wilson-mura/m4-avionics/README.md

# Martlet IV Avionics

This repository contains all the avionics for Martlet 4, including system 
design, documentation, schematics, PCBs, and firmware.
