wilson-mura/m4-avionics/m4pyro/schematic.pdf

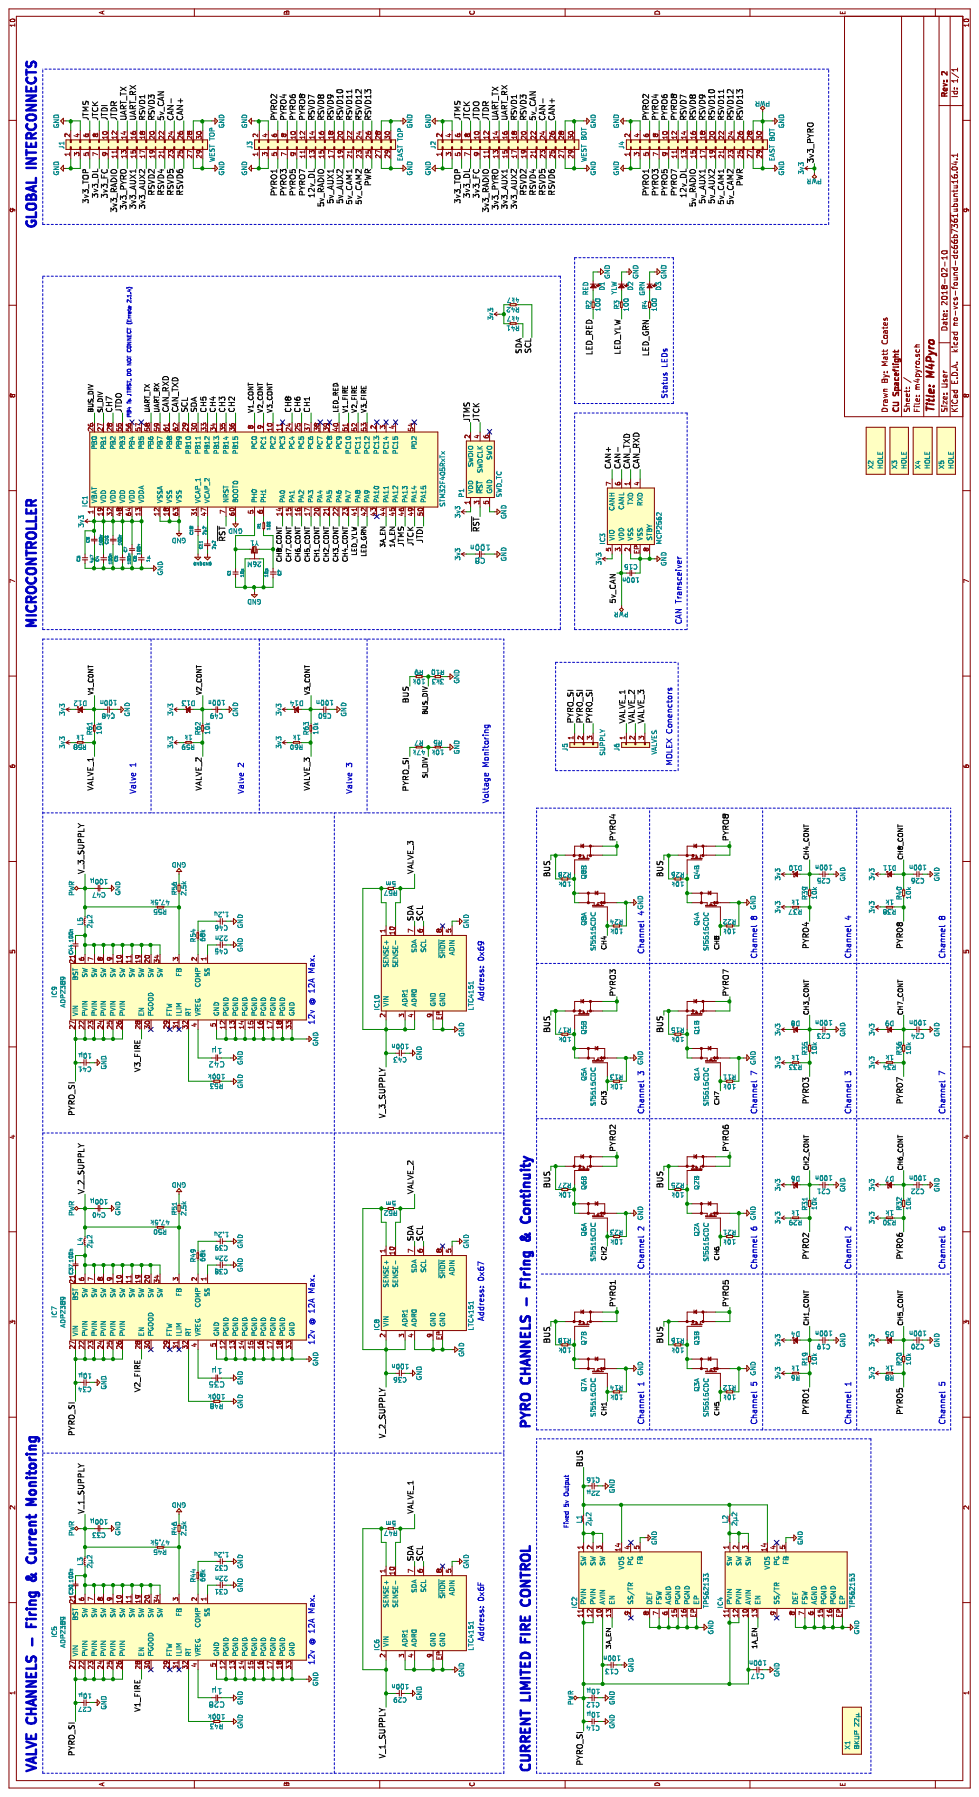
[picture p7: page 1]
