wilson-mura/m4-avionics/m4pyro/m4pyro.pdf

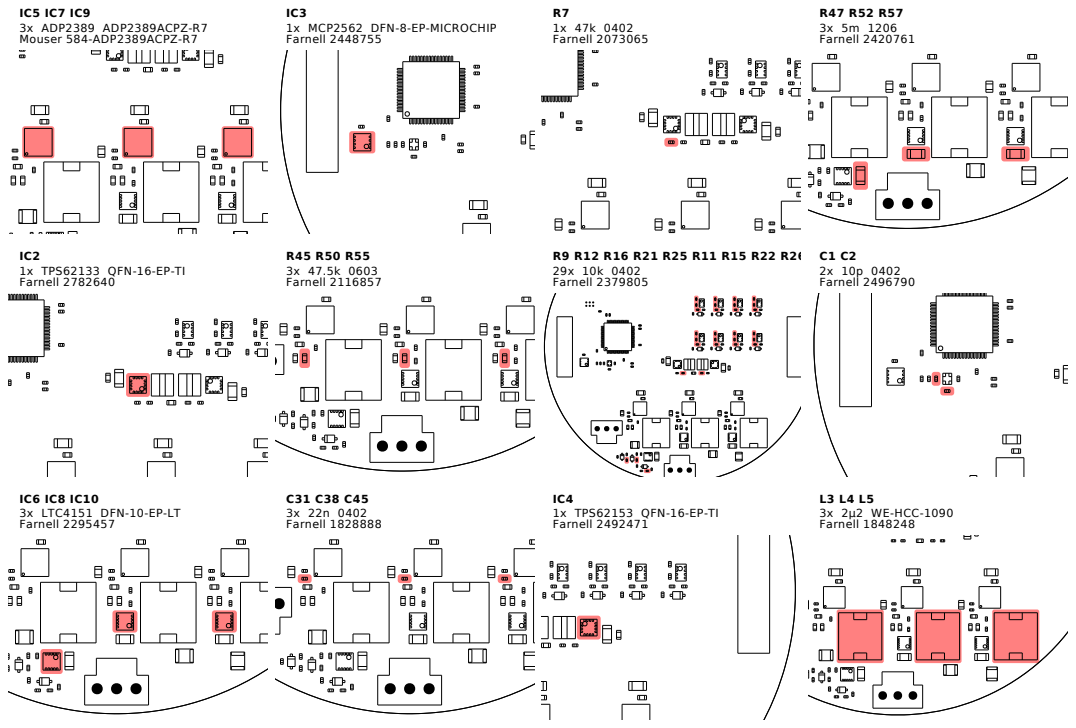
[picture p8: page 1]

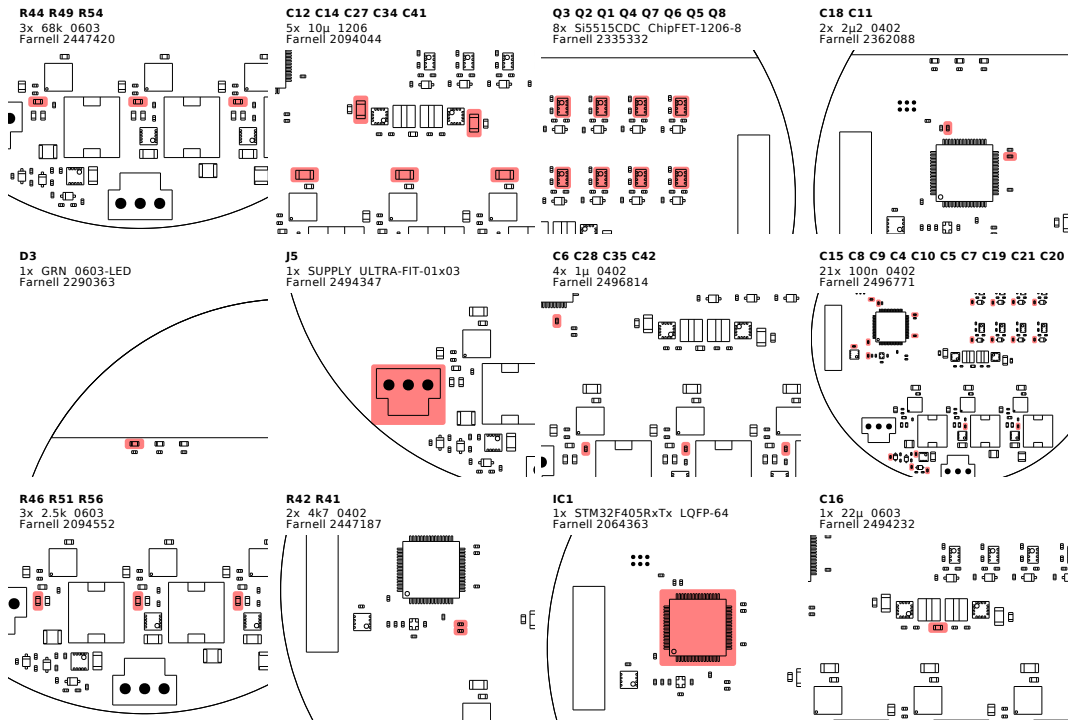
[picture p9: page 2]

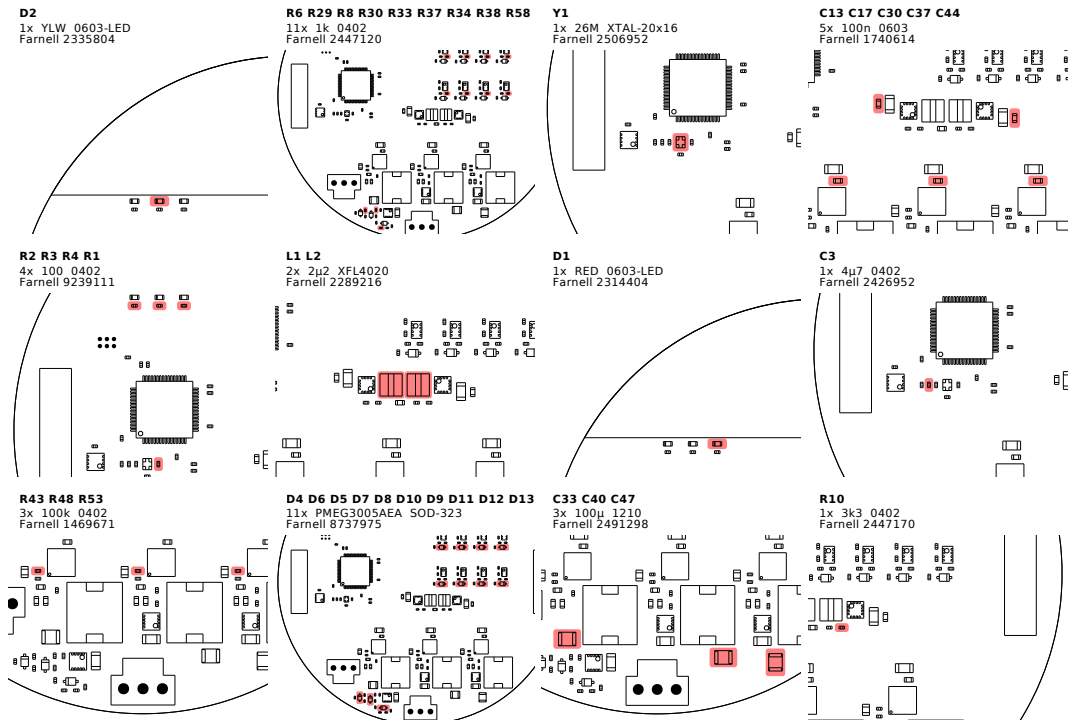
[picture p10: page 3]

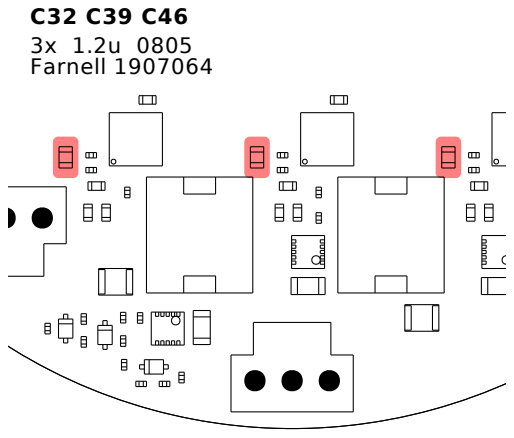
[picture p11: figure]
C32 C39 C46 3x 1.2u 0805 Farnell 1907064
