wilson-mura/m4-avionics/m4psu/m4psu.kicad_pcb

## KiCad design m4psu/m4psu.kicad_pcb (2018-03-01)

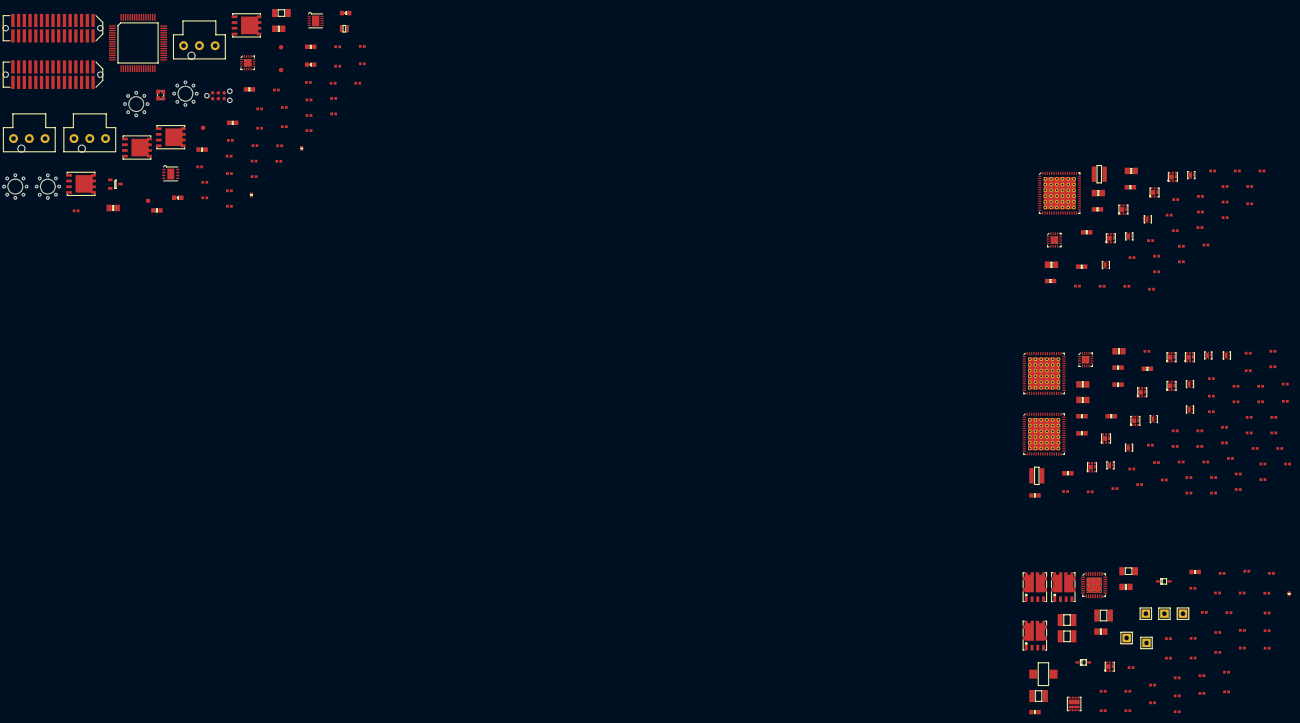
[picture p12: board m4psu.kicad_pcb from above]

Board: 2 copper layers, 246 parts (0 on the bottom side), 161 nets, no tracks yet.

Parts:
C1, C2: 10p; 0402
C3, C5, C6, C8, C9, C10, C11, C22, C25, C29, C30, C32, C33, C34, C37, C42, C45, C46, C49, C50, C51, C52, C54, C55, C56, C57, C58: 100n; 0402
C4: 4µ7; 0402
C7, C43, C48: 1µ; 0402
C12, C13: 2µ2; 0402
C14, C17: 22µ; 0805
C15, C18, C19, C20, C23, C38: 100n; 0603
C16, C26, C39: 3n3; 0402
C21, C35: 10u; 0805
C24, C31, C36: 10n; 0402
C27, C28, C40, C41: 22u; 0805
C44, C64: 2µ2; 0805
C47: 1µ5; 0603
C53: 100p; 0402
C59, C60, C62, C63: 10µ; 1210
C61: 22p; 0402
D1: RED; 0603-LED
D2: YLW; 0603-LED
D3: GRN; 0603-LED
D4, D5: SCHOTTKY; SOD-323
IC1: MCP2562; DFN-8-EP-MICROCHIP
IC2: STM32F405RxTx; LQFP-64
IC3: TPS62152; QFN-16-EP-TI
IC4: LTC4151; DFN-10-EP-LT
IC5: TLV76012; SOT-23
IC6: TPS62132; QFN-16-EP-TI
IC7, IC8, IC10: LTC2975; QFN-64-EP-LTC-UP
IC9: TPS62133; QFN-16-EP-TI
IC11: BQ40Z60; QFN-32-EP-TI
J1: WEST TOP; TFML-115-02-L-D-LC
J2: EAST TOP; TFML-115-02-L-D-LC
J3: SUPPLY; ULTRA-FIT-01x03
J4: VALVES; ULTRA-FIT-01x03
J5: CHG; ULTRA-FIT-01x03
J6: BAT+; SIL-254P-01
J7: TAP3; SIL-254P-01
J8: TAP2; SIL-254P-01
J9: TAP1; SIL-254P-01
J10: BAT-; SIL-254P-01
L1: 3µ3; VLS201610HBX-1
L2, L3: 2u2; XFL4020
L4: 2µ2; SRP5030T
P1: SWD_TC; TC2030-NL
Q1, Q2, Q3, Q5: PFET; PowerPAK-SO-8
Q4, Q6, Q33: NFET; SOT-883-B
Q7, Q9, Q11, Q13, Q15, Q17, Q19, Q21, Q23, Q25, Q27: NFET; PowerPAK-SC-75-6L-Single
Q8, Q10, Q12, Q14, Q16, Q18, Q20, Q22, Q24, Q26, Q28: PFET; SON2x2
Q29, Q30, Q32: NFET2; PowerFLAT-5x6
Q31: SiZ340DT; PowerPair-3x3
Q34: NFET; SON2x2N
R1, R2: 100k; 0402
R3, R5, R6, R7: 100; 0402
R4, R8, R9: 4k7; 0402
R10, R98: 2m; 1206
R11, R15: 47k; 0402
R12, R16, R19, R20, R21, R22, R23, R25, R26, R31, R32, R33, R34, R35, R37, R38, R63, R64, R65, R66, R67, R69, R70: 10k; 0402
R13, R14, R17, R18, R27, R29, R39, R41, R43, R45, R47, R49, R51, R53, R55, R57, R59, R61, R71, R73, R75, R77, R79, R81, R83, R85: 33k; 0402
R24, R36, R68: 5k49; 0402
R28, R40, R44, R48, R52, R56, R60, R72, R76, R80, R84: 1M; 0402
R30, R42, R46, R50, R54, R58, R62, R74, R78, R82, R86, R99: 10m; 0603
R87, R88, R92, R93, R94, R95: 100R; 0402
R89, R100, R105: 10M; 0402
R90, R96, R104: 5K1; 0402
R91, R97: 10R; 0402
R101: 330K; 0402
R102: 56K2; 0402
R103: 10K; 0402
R106: 100K; 0402
R107: 2R; 0402
R108: 120; 0603
TP1, TP2, TP3, TP4: TESTPAD
X1, X2, X3, X4: HOLE; M3_MOUNT
Y1: 26M; XTAL-20x16

Connections:
3v3: C4.2, C5.2, C6.2, C7.2, C8.2, C9.2, C10.2, C11.2, C17.2, IC1.5, IC2.1, IC2.13, IC2.19, IC2.32, IC2.48, IC2.64, IC3.7, IC3.14, L1.2, P1.1, R1.2, R4.2, R8.2, R9.2
3v3_B: C22.2, C27.1, C28.1, C30.2, C34.2, IC6.14, IC7.9, IC7.10, IC7.11, IC7.12, IC7.55, IC7.56, IC8.9, IC8.10, IC8.11, IC8.12, IC8.35, IC8.55, IC8.56, IC10.10, IC10.11, IC10.12, L2.2, Q8.S, Q10.S, Q12.S, Q14.S, Q16.S, Q18.S, Q20.S, R19.1, R20.1, R21.1, R22.1, R23.1, R24.1, R25.1, R26.1, R27.1, R29.1, R31.1, R32.1, R33.1, R34.1, R35.1, R36.1, R37.1, R38.1, R39.1, R41.1, R43.1, R45.1, R47.1, R49.1, R51.1, R53.1, R55.1, R57.1, R59.1, R61.1, R63.1, R64.1, R65.1, R66.1, R67.1, R68.1, R69.1, R70.1
5v_B: C40.1, C41.1, IC9.14, IC10.9, IC10.55, IC10.56, L3.2, Q22.S, Q24.S, Q26.S, Q28.S, R71.1, R73.1, R75.1, R77.1, R79.1, R81.1, R83.1, R85.1
/3v3/ISNS0+: IC7.1, IC7.41, Q8.D, R30.2
/3v3/ISNS1+: IC7.43, IC7.63, Q10.D, R42.2
/3v3/ISNS2+: IC7.45, IC7.61, Q12.D, R46.2
/3v3/ISNS3+: IC7.47, IC7.49, Q14.D, R50.2
/3v3/ISNS4+: IC8.1, IC8.41, Q16.D, R54.2
/3v3/ISNS5+: IC8.43, IC8.63, Q18.D, R58.2
/3v3/ISNS6+: IC8.45, IC8.61, Q20.D, R62.2
/3v3/VEN_0: IC7.3, Q7.G, R27.2, R28.1
/3v3/VEN_1: IC7.4, Q9.G, R39.2, R40.1
/3v3/VEN_2: IC7.5, Q11.G, R43.2, R44.1
/3v3/VEN_3: IC7.6, Q13.G, R47.2, R48.1
/3v3/VEN_4: IC8.3, Q15.G, R51.2, R52.1
/3v3/VEN_5: IC8.4, Q17.G, R55.2, R56.1
/3v3/VEN_6: IC8.5, Q19.G, R59.2, R60.1
/3v3_AUX1: IC8.44, J1.15, R58.1
/3v3_AUX2: IC8.46, J1.17, R62.1
/3v3_DL: IC7.44, J1.7, R42.1
/3v3_FC: IC7.46, J1.9, R46.1
/3v3_PYRO: IC8.42, J1.13, R54.1
/3v3_RADIO: IC7.48, J1.11, R50.1
/3v3_TOP: IC7.42, J1.5, R30.1
/5v/ISNS7+: IC10.1, IC10.41, Q22.D, R74.2
/5v/ISNS8+: IC10.43, IC10.63, Q24.D, R78.2
/5v/ISNS9+: IC10.45, IC10.61, Q26.D, R82.2
/5v/ISNS10+: IC10.47, IC10.49, Q28.D, R86.2
/5v/VEN_7: IC10.3, Q21.G, R71.2, R72.1
/5v/VEN_8: IC10.4, Q23.G, R75.2, R76.1
/5v/VEN_9: IC10.5, Q25.G, R79.2, R80.1
/5v/VEN_10: IC10.6, Q27.G, R83.2, R84.1
/5v_AUX1: IC10.44, J2.17, R78.1
/5v_AUX2: IC10.46, J2.19, R82.1
/5v_CAM1: IC10.48, J2.21, J2.23, R86.1
/5v_CAN: C3.1, IC1.3, J1.22
/5v_RADIO: IC10.42, J2.15, R74.1
/12v_DIV: IC2.21, R11.2, R12.1
/12v_DL: C20.2, IC5.1, J2.13, R11.1
/CAN+: IC1.7, J1.26, R108.2
/CAN-: IC1.6, J1.24, R108.1
/CAN_RXD: IC1.4, IC2.61
/CAN_TXD: IC1.1, IC2.62
/EN_POWER: IC2.43, Q6.G, R18.1
/EN_PYRO: IC2.16, Q4.G, R14.2
/JTCK: IC2.49, J1.8, P1.4
/JTDI: IC2.50, J1.10
/JTDR: IC2.55, J1.12
/JTMS: IC2.46, J1.6, P1.2
/LED_GRN: IC2.11, R7.1
/LED_RED: IC2.9, R5.1
/LED_YLW: IC2.10, R6.1
/PWR: J2.25, R1.1, R2.1
/PYRO_SO: J3.1, J3.2, J3.3, Q1.D, Q2.D, Q3.D, R15.1
/SCL: IC2.41, IC4.6, IC7.30, IC8.30, IC10.30, R8.1, R88.1, TP2.1
/SDA: IC2.40, IC4.7, IC7.29, IC8.29, IC10.29, R4.1, R87.1, TP1.1
/SO_DIV: IC2.22, R15.2, R16.1
/V_SHORE: J5.1, J5.2, Q33.S, Q34.S, R103.2, R105.1, R106.1, R107.1
/charger/ACFET: IC11.29, R104.2
/charger/ACP: IC11.31, R103.1
/charger/BATT1: J9.1, R95.2
/charger/BATT2: J8.1, R94.2
/charger/BATT3: J7.1, R93.2
/charger/BATT4: C45.1, J6.1, Q29.S1, Q29.S2, Q30.S1, R89.1, R92.2, R97.2
/charger/CHG: IC11.32, R90.2
/charger/DSG: IC11.30, R96.2
/charger/VCHARGE: C62.2, C63.2, Q31.D1, Q34.D, R91.2
/~ALERT: IC2.42, IC7.31, IC8.31, IC10.31, IC11.14, R9.1, TP3.1
/~RST: IC2.7, P1.3
/~WAKE: IC2.14, R2.2
GND: C1.1, C2.1, C3.2, C4.1, C5.1, C6.1, C7.1, C8.1, C9.1, C10.1, C11.1, C12.2, C13.2, C14.1, C15.1, C16.1, C17.1, C18.1, C19.1, C20.1, C21.2, C22.1, C23.2, C24.1, C25.1, C26.2, C27.2, C28.2, C30.1, C31.1, C32.1, C34.1, C35.2, C36.1, C37.1, C38.2, C39.2, C40.2, C41.2, C53.2, C54.2, C59.2, C60.2, C62.1, C63.1, C64.2, D1.1, D2.1, D3.1, IC1.2, IC1.8, IC1.EP, IC2.12, IC2.18, IC2.60, IC2.63, IC3.5, IC3.6, IC3.8, IC3.15, IC3.16, IC3.EP, IC4.3, IC4.4, IC4.5, IC4.9, IC4.EP, IC5.3, IC6.5, IC6.6, IC6.7, IC6.8, IC6.15, IC6.16, IC6.EP, IC7.2, IC7.15, IC7.16, IC7.19, IC7.20, IC7.21, IC7.27, IC7.28, IC7.34, IC7.36, IC7.37, IC7.39, IC7.50, IC7.52, IC7.59, IC7.60, IC7.62, IC7.64, IC7.EP, IC8.2, IC8.15, IC8.16, IC8.19, IC8.20, IC8.21, IC8.27, IC8.28, IC8.34, IC8.36, IC8.37, IC8.39, IC8.47, IC8.48, IC8.49, IC8.50, IC8.52, IC8.59, IC8.60, IC8.62, IC8.64, IC8.EP, IC9.5, IC9.6, IC9.7, IC9.8, IC9.15, IC9.16, IC9.EP, IC10.2, IC10.15, IC10.16, IC10.19, IC10.20, IC10.21, IC10.27, IC10.28, IC10.34, IC10.35, IC10.36, IC10.37, IC10.39, IC10.50, IC10.52, IC10.59, IC10.60, IC10.62, IC10.64, IC10.EP, IC11.7, IC11.24, J1.1, J1.2, J1.3, J1.4, J1.27, J1.28, J1.29, J1.30, J2.1, J2.2, J2.3, J2.4, J2.27, J2.28, J2.29, J2.30, J4.1, J4.2, J4.3, J5.3, P1.5, Q4.S, Q6.S, Q7.S, Q9.S, Q11.S, Q13.S, Q15.S, Q17.S, Q19.S, Q21.S, Q23.S, Q25.S, Q27.S, Q31.S2, Q33.G, R12.2, R14.1, R16.2, R18.2, R28.2, R40.2, R44.2, R48.2, R52.2, R56.2, R60.2, R72.2, R76.2, R80.2, R84.2, R98.1, R106.2, TP4.1, Y1.2, Y1.4
unnamed: C1.2, IC2.5, Y1.1
unnamed: C2.2, R3.1, Y1.3
unnamed: C12.1, IC2.47
unnamed: C13.1, IC2.31
unnamed: C16.2, IC3.9
unnamed: C24.2, IC7.51
unnamed: C25.2, IC7.13, IC7.14
unnamed: C26.1, IC6.9
unnamed: C29.1, IC7.38
unnamed: C29.2, IC7.40
unnamed: C31.2, IC8.51
unnamed: C32.2, IC8.13, IC8.14
unnamed: C33.1, IC8.38
unnamed: C33.2, IC8.40
unnamed: C36.2, IC10.51
unnamed: C37.2, IC10.13, IC10.14
unnamed: C39.1, IC9.9
unnamed: C42.1, IC10.38
unnamed: C42.2, IC10.40
unnamed: C43.2, IC11.22, R91.1
unnamed: C44.2, IC11.2
unnamed: C45.2, C55.2
unnamed: C46.1, D4.1, IC11.28
unnamed: C46.2, IC11.26, L4.2, Q31.S1D2
unnamed: C47.1, D4.2, IC11.23
unnamed: C48.1, D5.1, IC11.1
unnamed: C49.1, IC11.3, R92.1
unnamed: C49.2, C50.1, IC11.4, R93.1
unnamed: C50.2, C51.1, IC11.5, R94.1
unnamed: C51.2, C52.1, IC11.6, R95.1
unnamed: C56.2, C57.1, IC11.20, L4.1, R99.1
unnamed: C61.2, IC11.18, R101.2, R102.1
unnamed: C64.1, R107.2
unnamed: D1.2, R5.2
unnamed: D2.2, R6.2
unnamed: D3.2, R7.2
unnamed: D5.2, R97.1
unnamed: IC2.6, R3.2
unnamed: IC3.1, IC3.2, IC3.3, L1.1
unnamed: IC4.10, Q1.S, Q2.S, Q3.S, R10.1, R13.2
unnamed: IC6.1, IC6.2, IC6.3, L2.1
unnamed: IC7.18, R24.2
unnamed: IC7.22, R23.2
unnamed: IC7.23, R21.2
unnamed: IC7.24, R25.2
unnamed: IC7.25, R19.2
unnamed: IC7.26, R26.2
unnamed: IC7.32, R22.2
unnamed: IC7.33, R20.2
unnamed: IC8.18, R36.2
unnamed: IC8.22, R35.2
unnamed: IC8.23, R33.2
unnamed: IC8.24, R37.2
unnamed: IC8.25, R31.2
unnamed: IC8.26, R38.2
unnamed: IC8.32, R34.2
unnamed: IC8.33, R32.2
unnamed: IC9.1, IC9.2, IC9.3, L3.1
unnamed: IC10.18, R68.2
unnamed: IC10.22, R67.2
unnamed: IC10.23, R65.2
unnamed: IC10.24, R69.2
unnamed: IC10.25, R63.2
unnamed: IC10.26, R70.2
unnamed: IC10.32, R66.2
unnamed: IC10.33, R64.2
unnamed: IC11.16, R87.2
unnamed: IC11.17, R88.2
unnamed: IC11.25, Q31.G2
unnamed: IC11.27, Q31.G1
unnamed: Q1.G, Q2.G, Q3.G, Q4.D, R13.1
unnamed: Q5.G, Q6.D, R17.1
unnamed: Q7.D, Q8.G, R29.2
unnamed: Q9.D, Q10.G, R41.2
unnamed: Q11.D, Q12.G, R45.2
unnamed: Q13.D, Q14.G, R49.2
unnamed: Q15.D, Q16.G, R53.2
unnamed: Q17.D, Q18.G, R57.2
unnamed: Q19.D, Q20.G, R61.2
unnamed: Q21.D, Q22.G, R73.2
unnamed: Q23.D, Q24.G, R77.2
unnamed: Q25.D, Q26.G, R81.2
unnamed: Q27.D, Q28.G, R85.2
unnamed: Q29.D1, Q29.D2, Q30.D1, Q30.D2, Q32.D1, Q32.D2
unnamed: Q29.G1, Q29.G2, Q30.G1, R89.2, R90.1
unnamed: Q30.G2, Q32.G1, Q32.G2, R96.1, R100.2
unnamed: Q33.D, Q34.G, R104.1, R105.2
PGND: C43.1, C44.1, C47.2, C48.2, C52.2, C53.1, C54.1, C56.1, C58.1, IC11.8, IC11.9, IC11.21, IC11.EP, J10.1, R98.2, R102.2
VBATT: C14.2, C15.2, C18.2, C55.1, C57.2, C58.2, C59.1, C60.1, C61.1, IC3.10, IC3.11, IC3.12, IC3.13, IC4.1, IC4.2, IC11.19, Q5.S, Q30.S2, Q32.S1, Q32.S2, R10.2, R17.2, R99.2, R100.1, R101.1
VCC: C19.2, C21.1, C23.1, C35.1, C38.1, IC5.2, IC6.10, IC6.11, IC6.12, IC6.13, IC9.10, IC9.11, IC9.12, IC9.13, Q5.D
