wilson-mura/m4-avionics/m4pyro/m4pyro.kicad_pcb

## KiCad design m4pyro/m4pyro.kicad_pcb (2018-02-25)

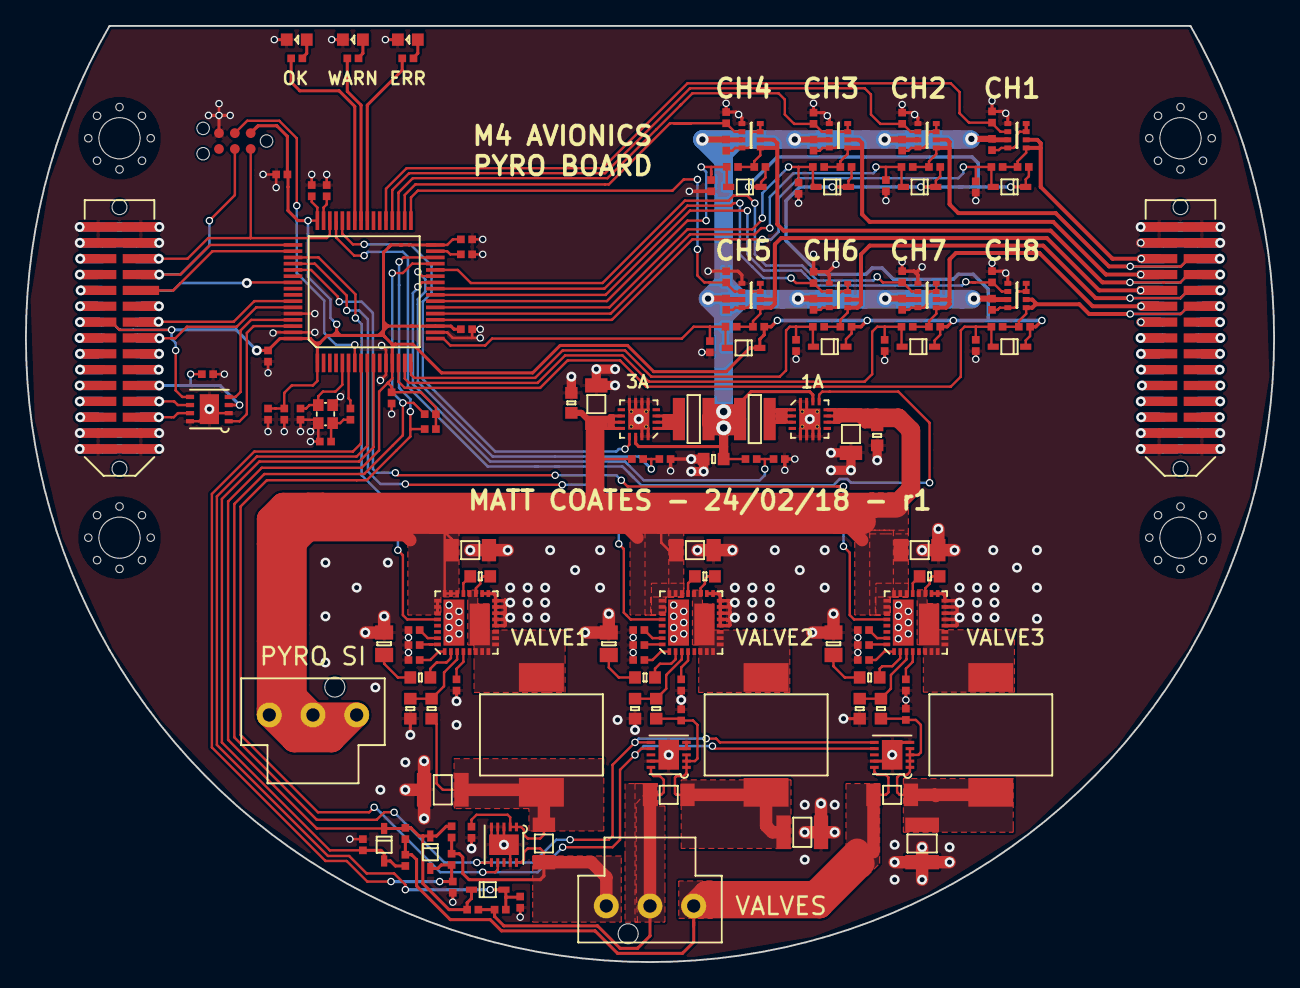
[picture p13: board m4pyro.kicad_pcb from above]

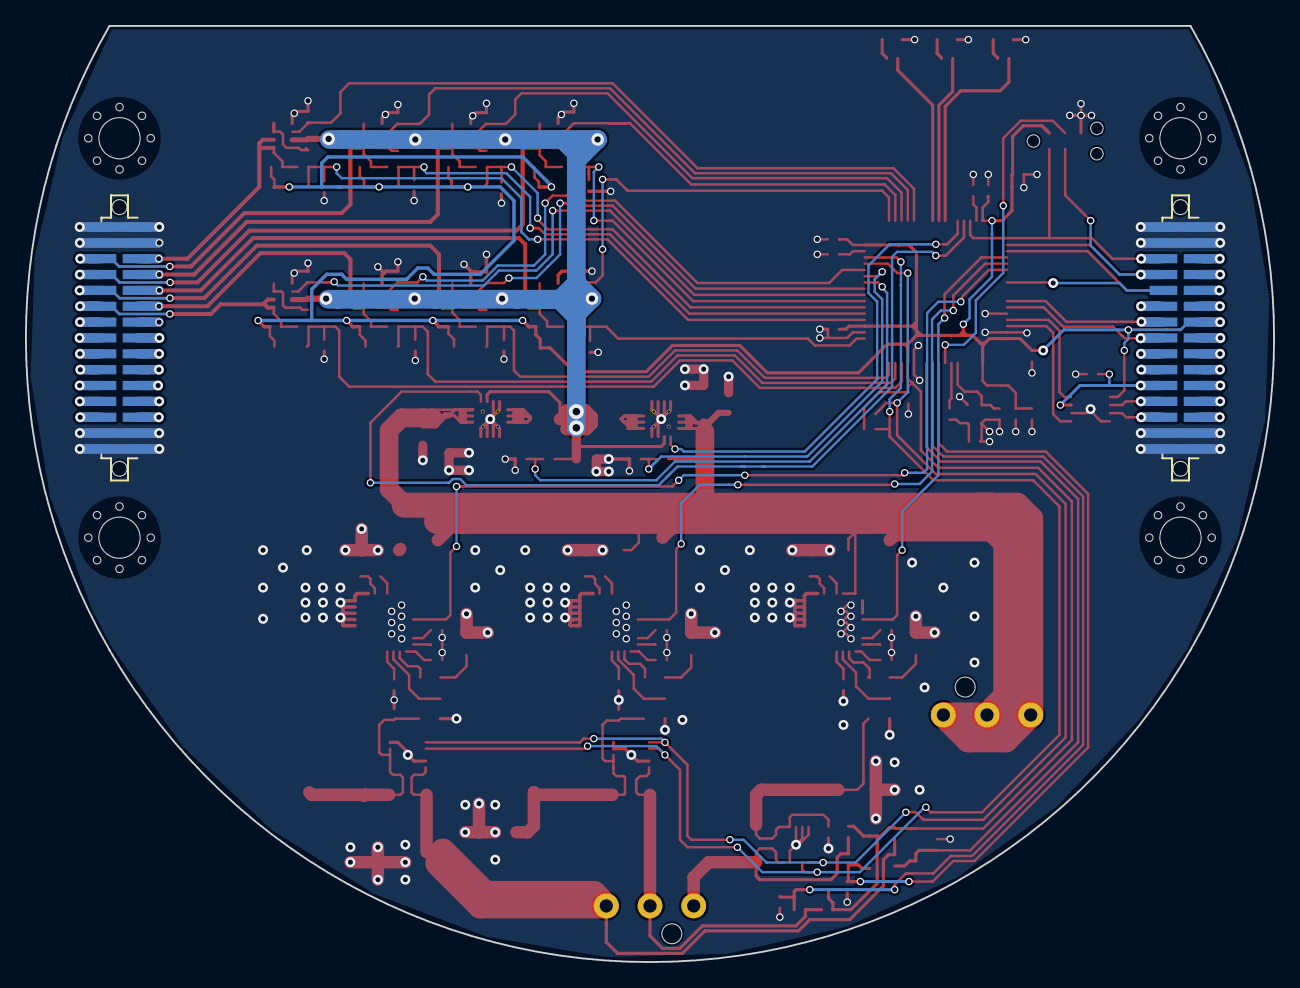
[picture p14: board m4pyro.kicad_pcb from below]

Board: 2 copper layers, 100.0 x 75.0 mm, 165 parts (2 on the bottom side), 133 nets.

Parts:
C1, C2: 10p; 0402
C3: 4µ7; 0402
C4, C5, C7, C8, C9, C10, C15, C19, C20, C21, C22, C23, C24, C25, C26, C29, C36, C43, C48, C49, C50: 100n; 0402
C6, C28, C35, C42: 1µ; 0402
C11, C18: 2µ2; 0402
C12, C14, C27, C34, C41: 10µ; 1206
C13, C17, C30, C37, C44: 100n; 0603
C16: 22µ; 0603
C31, C38, C45: 22n; 0402
C32, C39, C46: 1.2u; 0805
C33, C40, C47: 100µ; 1210
D1: RED; 0603-LED
D2: YLW; 0603-LED
D3: GRN; 0603-LED
D4, D5, D6, D7, D8, D9, D10, D11, D12, D13, D14: PMEG3005AEA; SOD-323
IC1: STM32F405RxTx; LQFP-64
IC2: TPS62133; QFN-16-EP-TI
IC3: MCP2562; DFN-8-EP-MICROCHIP
IC4: TPS62153; QFN-16-EP-TI
IC5, IC7, IC9: ADP2389; ADP2389ACPZ-R7
IC6, IC8, IC10: LTC4151; DFN-10-EP-LT
J1: WEST TOP; TFML-115-02-L-D-LC
J2: WEST BOT; SFML-115-02-L-D
J3: EAST TOP; TFML-115-02-L-D-LC
J4: EAST BOT; SFML-115-02-L-D
J5: SUPPLY; ultra-fit-01x03
J6: VALVES; ultra-fit-01x03
L1, L2: 2µ2; XFL4020
L3, L4, L5: 2µ2; WE-HCC-1090
P1: SWD_TC; TC2030-NL
Q1, Q2, Q3, Q4, Q5, Q6, Q7, Q8: Si5515CDC; ChipFET-1206-8
R1, R2, R3, R4: 100; 0402
R5, R9, R11, R12, R13, R14, R15, R16, R17, R18, R19, R20, R21, R22, R23, R24, R25, R26, R27, R28, R31, R32, R35, R36, R39, R40, R61, R62, R63: 10k; 0402
R6, R8, R29, R30, R33, R34, R37, R38, R58, R59, R60: 1k; 0402
R7: 47k; 0402
R10: 3k3; 0402
R41, R42: 4k7; 0402
R43, R48, R53: 100k; 0402
R44, R49, R54: 68k; 0603
R45, R50, R55: 47.5k; 0603
R46, R51, R56: 2.5k; 0603
R47, R52, R57: 5m; 1206
R64, R65, R66: 82.5k; 0402
X2, X3, X4, X5: HOLE; M3_MOUNT
Y1: 26M; XTAL-20x16

Connections:
3v3: C3.2, C4.2, C5.2, C6.2, C7.2, C8.2, C9.2, C10.2, D4.1, D5.1, D6.1, D7.1, D8.1, D9.1, D10.1, D11.1, D12.1, D13.1, D14.1, IC1.1, IC1.13, IC1.19, IC1.32, IC1.48, IC1.64, IC3.5, J1.13, J2.13, P1.1, R6.2, R8.2, R29.2, R30.2, R33.2, R34.2, R37.2, R38.2, R41.2, R42.2, R58.2, R59.2, R60.2
/1A_EN: IC1.45, IC4.13
/3A_EN: IC1.44, IC2.13
/3v3_AUX1: J1.15, J2.15
/3v3_AUX2: J1.17, J2.17
/3v3_DL: J1.7, J2.7
/3v3_FC: J1.9, J2.9
/3v3_RADIO: J1.11, J2.11
/3v3_TOP: J1.5, J2.5
/5v_AUX1: J3.17, J4.17
/5v_AUX2: J3.19, J4.19
/5v_CAM1: J3.21, J4.21
/5v_CAM2: J3.23, J4.23
/5v_CAN: C15.1, IC3.3, J1.22, J2.22
/5v_RADIO: J3.15, J4.15
/12v_DL: J3.13, J4.13
/BUS: C16.1, IC2.14, IC4.14, L1.2, L2.2, Q1.3, Q2.3, Q3.3, Q4.3, Q5.3, Q6.3, Q7.3, Q8.3, R9.1, R15.1, R16.1, R17.1, R18.1, R25.1, R26.1, R27.1, R28.1
/BUS_DIV: IC1.26, R9.2, R10.1
/CAN+: IC3.7, J1.26, J2.26
/CAN-: IC3.6, J1.24, J2.24
/CAN_RXD: IC1.61, IC3.4
/CAN_TXD: IC1.62, IC3.1
/CH1: IC1.37, Q7.2, R14.1
/CH1_CONT: C19.2, D4.2, IC1.20, R19.2
/CH2: IC1.36, Q6.2, R23.1
/CH2_CONT: C21.2, D6.2, IC1.21, R31.2
/CH3: IC1.35, Q5.2, R13.1
/CH3_CONT: C23.2, D8.2, IC1.22, R35.2
/CH4: IC1.34, Q8.2, R24.1
/CH4_CONT: C25.2, D10.2, IC1.23, R39.2
/CH5: IC1.33, Q3.2, R12.1
/CH5_CONT: C20.2, D5.2, IC1.17, R20.2
/CH6: IC1.25, Q2.2, R21.1
/CH6_CONT: C22.2, D7.2, IC1.16, R32.2
/CH7: IC1.28, Q1.2, R11.1
/CH7_CONT: C24.2, D9.2, IC1.15, R36.2
/CH8: IC1.24, Q4.2, R22.1
/CH8_CONT: C26.2, D11.2, IC1.14, R40.2
/JTCK: IC1.49, J1.8, J2.8, P1.4
/JTDI: IC1.50, J1.10
/JTDO: IC1.55, J2.10
/JTDR: J1.12, J2.12
/JTMS: IC1.46, J1.6, J2.6, P1.2
/LED_GRN: IC1.42, R4.1
/LED_RED: IC1.40, R2.1
/LED_YLW: IC1.41, R3.1
/PWR: J3.25, J4.25
/PYRO1: J3.5, J4.5, Q7.5, Q7.6, R6.1, R19.1
/PYRO2: J3.6, J4.6, Q6.5, Q6.6, R29.1, R31.1
/PYRO3: J3.7, J4.7, Q5.5, Q5.6, R33.1, R35.1
/PYRO4: J3.8, J4.8, Q8.5, Q8.6, R37.1, R39.1
/PYRO5: J3.9, J4.9, Q3.5, Q3.6, R8.1, R20.1
/PYRO6: J3.10, J4.10, Q2.5, Q2.6, R30.1, R32.1
/PYRO7: J3.11, J4.11, Q1.5, Q1.6, R34.1, R36.1
/PYRO8: J3.12, J4.12, Q4.5, Q4.6, R38.1, R40.1
/PYRO_SI: C12.2, C13.2, C14.2, C17.2, C27.2, C34.2, C41.2, IC2.10, IC2.11, IC2.12, IC4.10, IC4.11, IC4.12, IC5.22, IC5.23, IC5.24, IC5.25, IC5.26, IC5.27, IC7.22, IC7.23, IC7.24, IC7.25, IC7.26, IC7.27, IC9.22, IC9.23, IC9.24, IC9.25, IC9.26, IC9.27, J5.1, J5.2, J5.3, R7.1
/RSVD1: J1.18, J2.18
/RSVD2: J1.19, J2.19
/RSVD3: J1.20, J2.20
/RSVD4: J1.21, J2.21
/RSVD5: J1.23, J2.23
/RSVD6: J1.25, J2.25
/RSVD7: J3.14, J4.14
/RSVD8: J3.16, J4.16
/RSVD9: J3.18, J4.18
/RSVD10: J3.20, J4.20
/RSVD11: J3.22, J4.22
/RSVD12: J3.24, J4.24
/RSVD13: J3.26, J4.26
/SCL: IC1.29, IC6.6, IC8.6, IC10.6, R42.1
/SDA: IC1.30, IC6.7, IC8.7, IC10.7, R41.1
/SI_DIV: IC1.27, R5.1, R7.2
/UART_RX: IC1.59, J1.16, J2.16
/UART_TX: IC1.58, J1.14, J2.14
/V1_CONT: C48.2, D12.2, IC1.8, R61.2
/V1_FIRE: IC1.51, IC5.28
/V2_CONT: C49.2, D13.2, IC1.9, R62.2
/V2_FIRE: IC1.52, IC7.28
/V3_CONT: C50.2, D14.2, IC1.10, R63.2
/V3_FIRE: IC1.53, IC9.28
/VALVE_1: IC6.10, J6.1, R47.1, R58.1, R61.1
/VALVE_2: IC8.10, J6.2, R52.1, R59.1, R62.1
/VALVE_3: IC10.10, J6.3, R57.1, R60.1, R63.1
/V_1_SUPPLY: C29.2, C33.2, IC6.1, IC6.2, L3.2, R45.2, R47.2
/V_2_SUPPLY: C36.2, C40.2, IC8.1, IC8.2, IC8.3, L4.2, R50.2, R52.2
/V_3_SUPPLY: C43.2, C47.2, IC10.1, IC10.2, IC10.3, IC10.4, L5.2, R55.2, R57.2
/~RST: IC1.7, P1.3
GND: C1.1, C2.1, C3.1, C4.1, C5.1, C6.1, C7.1, C8.1, C9.1, C10.1, C11.2, C12.1, C13.1, C14.1, C15.2, C16.2, C17.1, C18.2, C19.1, C20.1, C21.1, C22.1, C23.1, C24.1, C25.1, C26.1, C27.1, C28.1, C29.1, C31.1, C32.1, C33.1, C34.1, C35.1, C36.1, C38.1, C39.1, C40.1, C41.1, C42.1, C43.1, C45.1, C46.1, C47.1, C48.1, C49.1, C50.1, D1.1, D2.1, D3.1, IC1.12, IC1.18, IC1.60, IC1.63, IC2.5, IC2.6, IC2.7, IC2.8, IC2.15, IC2.16, IC2.EP, IC3.2, IC3.8, IC3.EP, IC4.5, IC4.6, IC4.7, IC4.8, IC4.15, IC4.16, IC4.EP, IC5.5, IC5.12, IC5.13, IC5.14, IC5.15, IC5.16, IC5.17, IC5.18, IC5.33, IC6.3, IC6.4, IC6.5, IC6.9, IC6.EP, IC7.5, IC7.12, IC7.13, IC7.14, IC7.15, IC7.16, IC7.17, IC7.18, IC7.33, IC8.4, IC8.5, IC8.9, IC8.EP, IC9.5, IC9.12, IC9.13, IC9.14, IC9.15, IC9.16, IC9.17, IC9.18, IC9.33, IC10.5, IC10.9, IC10.EP, J1.1, J1.2, J1.3, J1.4, J1.27, J1.28, J1.29, J1.30, J2.1, J2.2, J2.3, J2.4, J2.27, J2.28, J2.29, J2.30, J3.1, J3.2, J3.3, J3.4, J3.27, J3.28, J3.29, J3.30, J4.1, J4.2, J4.3, J4.4, J4.27, J4.28, J4.29, J4.30, P1.5, Q1.1, Q2.1, Q3.1, Q4.1, Q5.1, Q6.1, Q7.1, Q8.1, R5.2, R10.2, R11.2, R12.2, R13.2, R14.2, R21.2, R22.2, R23.2, R24.2, R43.1, R46.2, R48.1, R51.2, R53.1, R56.2, R64.1, R65.1, R66.1, Y1.2, Y1.4
unnamed: C1.2, IC1.5, Y1.1
unnamed: C2.2, R1.1, Y1.3
unnamed: C11.1, IC1.47
unnamed: C18.1, IC1.31
unnamed: C28.2, IC5.4
unnamed: C30.1, IC5.21
unnamed: C30.2, IC5.6, IC5.7, IC5.8, IC5.9, IC5.10, IC5.11, IC5.19, IC5.20, IC5.34, L3.1
unnamed: C31.2, IC5.1
unnamed: C32.2, R44.2
unnamed: C35.2, IC7.4
unnamed: C37.1, IC7.21
unnamed: C37.2, IC7.6, IC7.7, IC7.8, IC7.9, IC7.10, IC7.11, IC7.19, IC7.20, IC7.34, L4.1
unnamed: C38.2, IC7.1
unnamed: C39.2, R49.2
unnamed: C42.2, IC9.4
unnamed: C44.1, IC9.21
unnamed: C44.2, IC9.6, IC9.7, IC9.8, IC9.9, IC9.10, IC9.11, IC9.19, IC9.20, IC9.34, L5.1
unnamed: C45.2, IC9.1
unnamed: C46.2, R54.2
unnamed: D1.2, R2.2
unnamed: D2.2, R3.2
unnamed: D3.2, R4.2
unnamed: IC1.6, R1.2
unnamed: IC2.1, IC2.2, IC2.3, L1.1
unnamed: IC4.1, IC4.2, IC4.3, L2.1
unnamed: IC5.2, R44.1
unnamed: IC5.3, R45.1, R46.1
unnamed: IC5.31, R64.2
unnamed: IC5.32, R43.2
unnamed: IC7.2, R49.1
unnamed: IC7.3, R50.1, R51.1
unnamed: IC7.31, R65.2
unnamed: IC7.32, R48.2
unnamed: IC9.2, R54.1
unnamed: IC9.3, R55.1, R56.1
unnamed: IC9.31, R66.2
unnamed: IC9.32, R53.2
unnamed: Q1.4, Q1.7, Q1.8, R15.2
unnamed: Q2.4, Q2.7, Q2.8, R25.2
unnamed: Q3.4, Q3.7, Q3.8, R16.2
unnamed: Q4.4, Q4.7, Q4.8, R26.2
unnamed: Q5.4, Q5.7, Q5.8, R17.2
unnamed: Q6.4, Q6.7, Q6.8, R27.2
unnamed: Q7.4, Q7.7, Q7.8, R18.2
unnamed: Q8.4, Q8.7, Q8.8, R28.2
