wilson-mura/m4-avionics/(commit log)

2018-02-03 added add-kicad
2018-02-03 started datalogger and finalised interconnect layout
    [m4dl.kicad_pcb, m4dl.sch]
2018-02-04 Begin m4fc
    [m4fc.kicad_pcb, m4fc.sch]
2018-02-04 moved pwr switch and removed chg from golbal interconnect
    [m4dl.sch]
2018-02-04 Tidy m3fc schematic
    [m4fc.kicad_pcb, m4fc.sch]
2018-02-08 started pyro board
    [m4pyro.sch]
2018-02-09 added valve fire and monitor stuff, need to think about continuity
    [m4pyro.kicad_pcb, m4pyro.sch]
2018-02-10 pyro schematic almost done
    [m4pyro.kicad_pcb, m4pyro.sch]
2018-02-11 started pyro pcb
    [m4pyro.kicad_pcb, m4pyro.sch]
2018-02-15 strain gauge circuit added to data logger
    [m4dl.sch]
2018-02-15 laying out pyro valve components
    [m4pyro.kicad_pcb, m4pyro.sch]
2018-02-16 added pcb template
    [m4pyro.kicad_pcb, pcb_template.kicad_pcb]
2018-02-16 put down high current tracks
    [_saved_m4pyro.sch, m4pyro.kicad_pcb]
2018-02-16 added gnd vias and continuity circuits
    [m4pyro.kicad_pcb]
2018-02-17 started mcu layout
    [_saved_m4pyro.sch, m4pyro.kicad_pcb, m4pyro.sch]
2018-02-18 pcb progress
    [m4pyro.kicad_pcb]
2018-02-21 continued pyro board layout
    [m4pyro.kicad_pcb]
2018-02-23 made good progress on pyro routing
    [m4pyro.kicad_pcb, m4pyro.sch]
2018-02-24 routed pyro board
    [m4pyro.kicad_pcb, m4pyro.sch]
2018-02-24 added bom
2018-02-24 started PSU
    [m4psu.sch]
2018-02-24 added ilim resistor to pyro board
    [m4psu.sch, m4pyro.kicad_pcb, m4pyro.sch]
2018-02-25 strain gauge filter circuit added
    [m4dl.sch]
2018-02-25 updated pressure label, groundss
    [m4dl.sch]
2018-02-25 Thermo circuitry added
    [m4dl.sch]
2018-02-25 added annotations to test pads
    [m4dl.sch]
2018-02-25 fixed second op amp
    [m4dl.sch]
2018-02-28 did dcdc converters
    [3v3.sch, 5_12v.sch, 5v.sch, m4psu.sch]
2018-03-01 finished psu schematic - needs review/checking
    [3v3.sch, 5_12v.sch, 5v.sch, charger.sch, m4psu.kicad_pcb, m4psu.sch]
